lucimobility/luci-sdk-encoders/README.md

# luci-sdk-encoders #
Please note all documentation lives in the [docs folder](docs/1_encoders.md) or at the 
[LUCI SDK](https://lucimobility.github.io/luci-ros2-sdk-docs/) website.
