lucimobility/luci-sdk-encoders/docs/3_firmware.md

# Firmware # 
[GitHub repo](https://github.com/lucimobility/luci-sdk-encoders)
The encoder board is based on the [Arduino Uno](https://store.arduino.cc/products/arduino-uno-rev3)
