lucimobility/luci-sdk-encoders/docs/2_shield.md

# Shield #
Shield
The shield was designed with KiCad. All future changes to the board will be kept in KiCad.

## Design ##
Schematic pdf can be found [here](files/schematic.pdf)

## BOM ##
Bill of Materials can be found [here](files/shield-purchase.csv)
