lucimobility/luci-sdk-encoders/Hardware/ENCODER PCB MOUNT.STEP

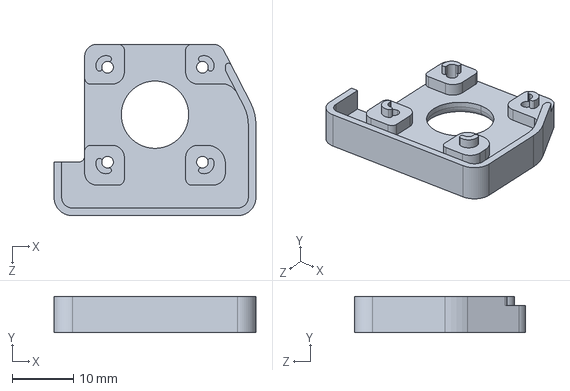
[picture p3: CAD file, 2023-06-07]
Hardware/ENCODER PCB MOUNT.STEP
33.0 x 5.90 x 28.0 mm
