lucimobility/luci-sdk-encoders/Hardware/Permobil_F3/ENCODER MOUNT ARM- PERMOBIL F3.STEP

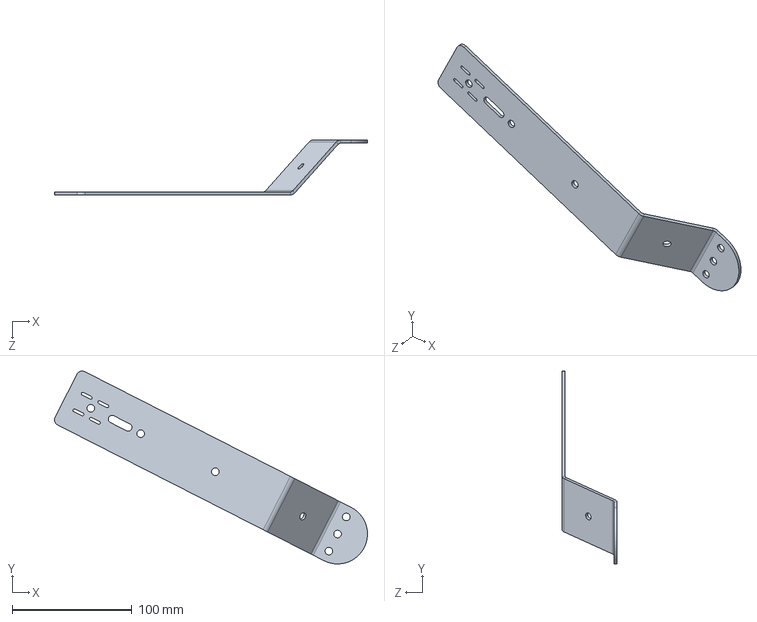
[picture p4: CAD file, 2023-06-07]
Hardware/Permobil_F3/ENCODER MOUNT ARM- PERMOBIL F3.STEP
261.4 x 161.1 x 46.0 mm
