lucimobility/luci-sdk-encoders/Hardware/Permobil_M3/INNER ENCODER MOUNT- PERMOBIL M3.STEP

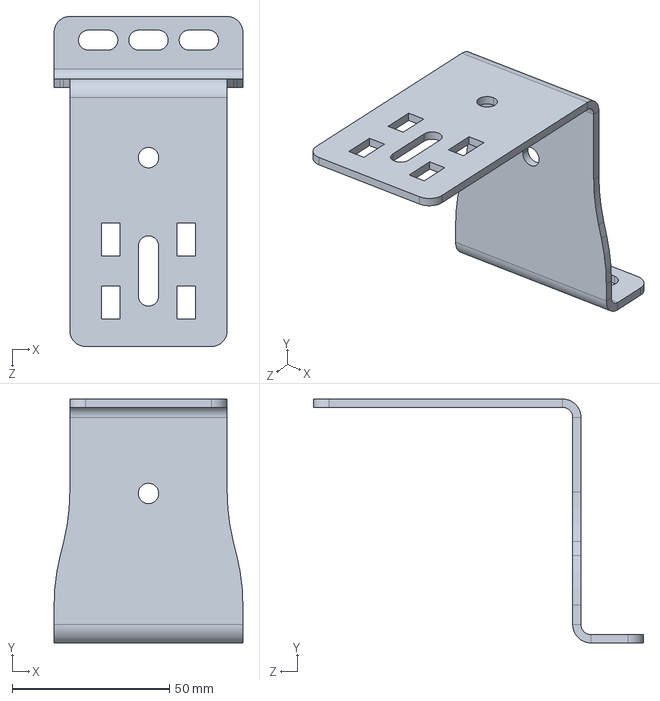
[picture p5: CAD file, 2023-06-07]
Hardware/Permobil_M3/INNER ENCODER MOUNT- PERMOBIL M3.STEP
60.0 x 77.5 x 104.8 mm
