lucimobility/luci-sdk-encoders/Hardware/Quickie_300M/ENCODER WHEEL ADAPTER- Q300M.STEP

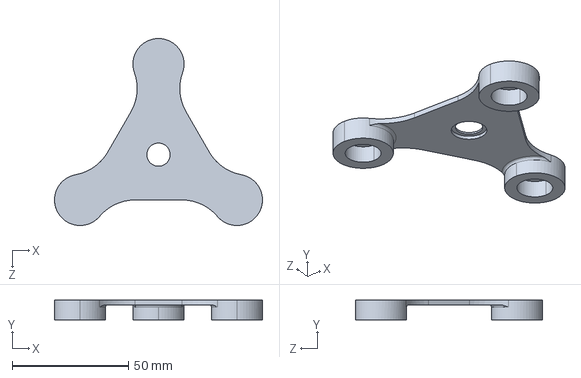
[picture p6: CAD file, 2023-06-07]
Hardware/Quickie_300M/ENCODER WHEEL ADAPTER- Q300M.STEP
89.5 x 8.50 x 80.5 mm
