lucimobility/luci-sdk-encoders/Hardware/Permobil_F3/ENCODER MOUNT- PERMOBIL F3.STEP

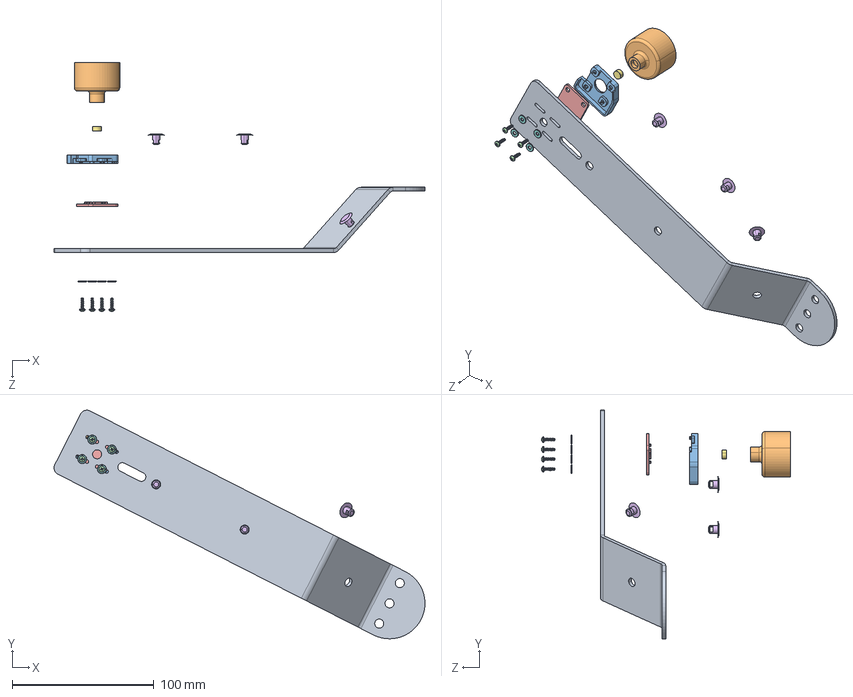
[picture p7: CAD file, 2023-06-07]
Hardware/Permobil_F3/ENCODER MOUNT- PERMOBIL F3.STEP
261.4 x 161.1 x 175.3 mm
ENCODER MOUNT ARM- PERMOBIL F3_default
ENCODER WHEEL ADAPTER- PERMOBIL F3_417-00011
ENCODER PCB MOUNT_417-00010
SCREW- #2 X 0.375_default x 4
ENCODER PCB_ENCODER PCB
CABLE TIE MOUNT_default x 3
MAGNET- NEODYMIUM 0.25 X 0.125_default
WASHER- #2_default x 4
