lucimobility/luci-sdk-encoders/Hardware/Permobil_M3/OUTER ENCODER MOUNT- PERMOBIL M3.STEP

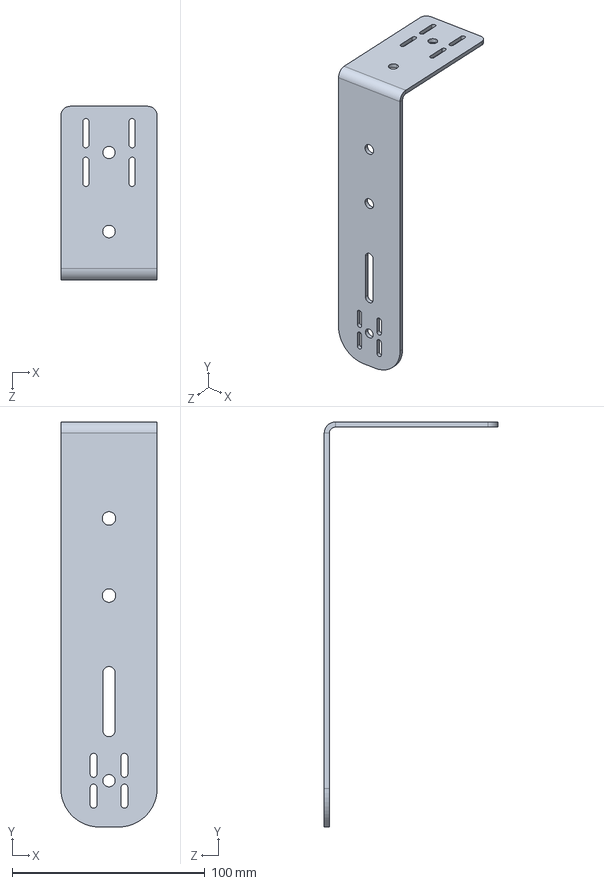
[picture p8: CAD file, 2023-06-07]
Hardware/Permobil_M3/OUTER ENCODER MOUNT- PERMOBIL M3.STEP
50.0 x 210.0 x 90.0 mm
