lucimobility/luci-sdk-encoders/Hardware/Quickie_500M/LEFT INNER ENCODER MOUNT- Q300M.STEP

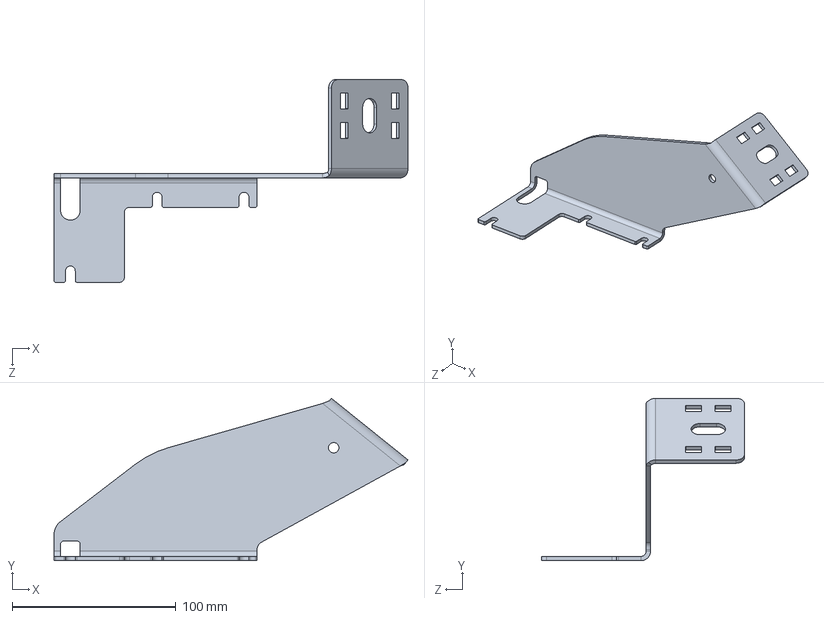
[picture p9: CAD file, 2023-06-07]
Hardware/Quickie_500M/LEFT INNER ENCODER MOUNT- Q300M.STEP
216.1 x 99.1 x 123.8 mm
