lucimobility/luci-sdk-encoders/Hardware/Permobil_F3/ENCODER WHEEL ADAPTER- PERMOBIL F3.STEP

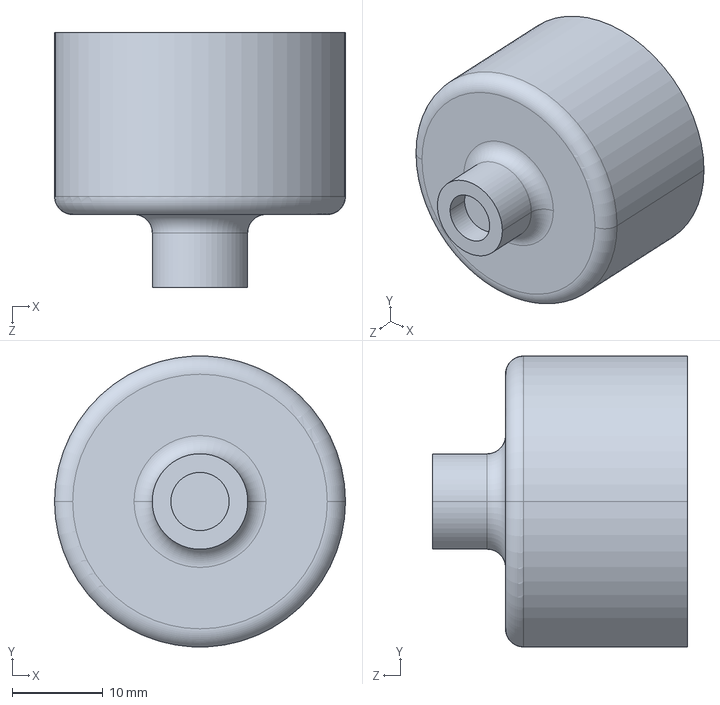
[picture p10: CAD file, 2023-06-07]
Hardware/Permobil_F3/ENCODER WHEEL ADAPTER- PERMOBIL F3.STEP
32.0 x 32.0 x 28.0 mm
