lucimobility/luci-sdk-encoders/Hardware/Quickie_300M/OUTER ENCODER MOUNT- Q300M.STEP

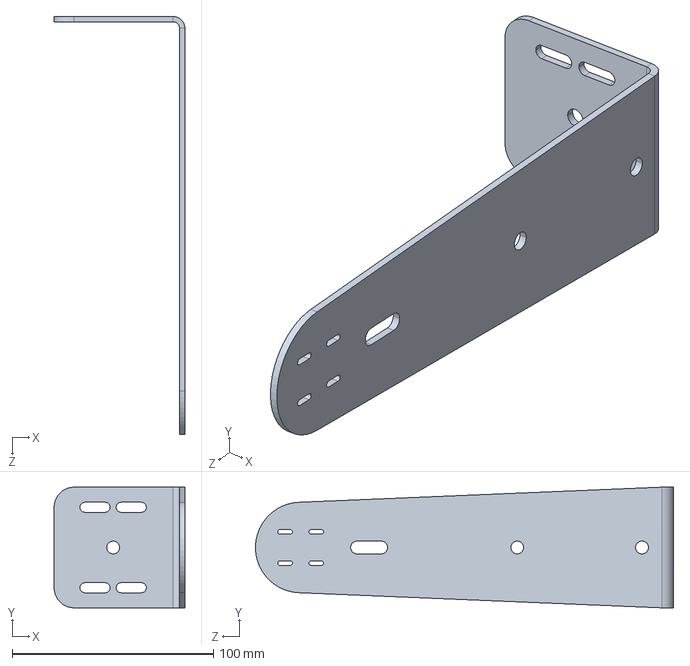
[picture p11: CAD file, 2023-06-07]
Hardware/Quickie_300M/OUTER ENCODER MOUNT- Q300M.STEP
65.0 x 60.0 x 207.8 mm
