lucimobility/luci-sdk-encoders/(list of files, cad)

Other CAD files:
Hardware/Quickie_500M/RIGHT INNER ENCODER MOUNT- Q300M.STEP
Hardware/Quickie_300M/RIGHT INNER ENCODER MOUNT- Q300M.STEP
Hardware/ENCODER PCB MOUNT.STL
Hardware/Quickie_500M/ENCODER MAGNET MOUNT- Q300M.STL
Hardware/Quickie_500M/ENCODER WHEEL ADAPTER- Q300M.STL
