lucimobility/luci-sdk-encoders/Hardware/ENCODER PCB MOUNT.PDF

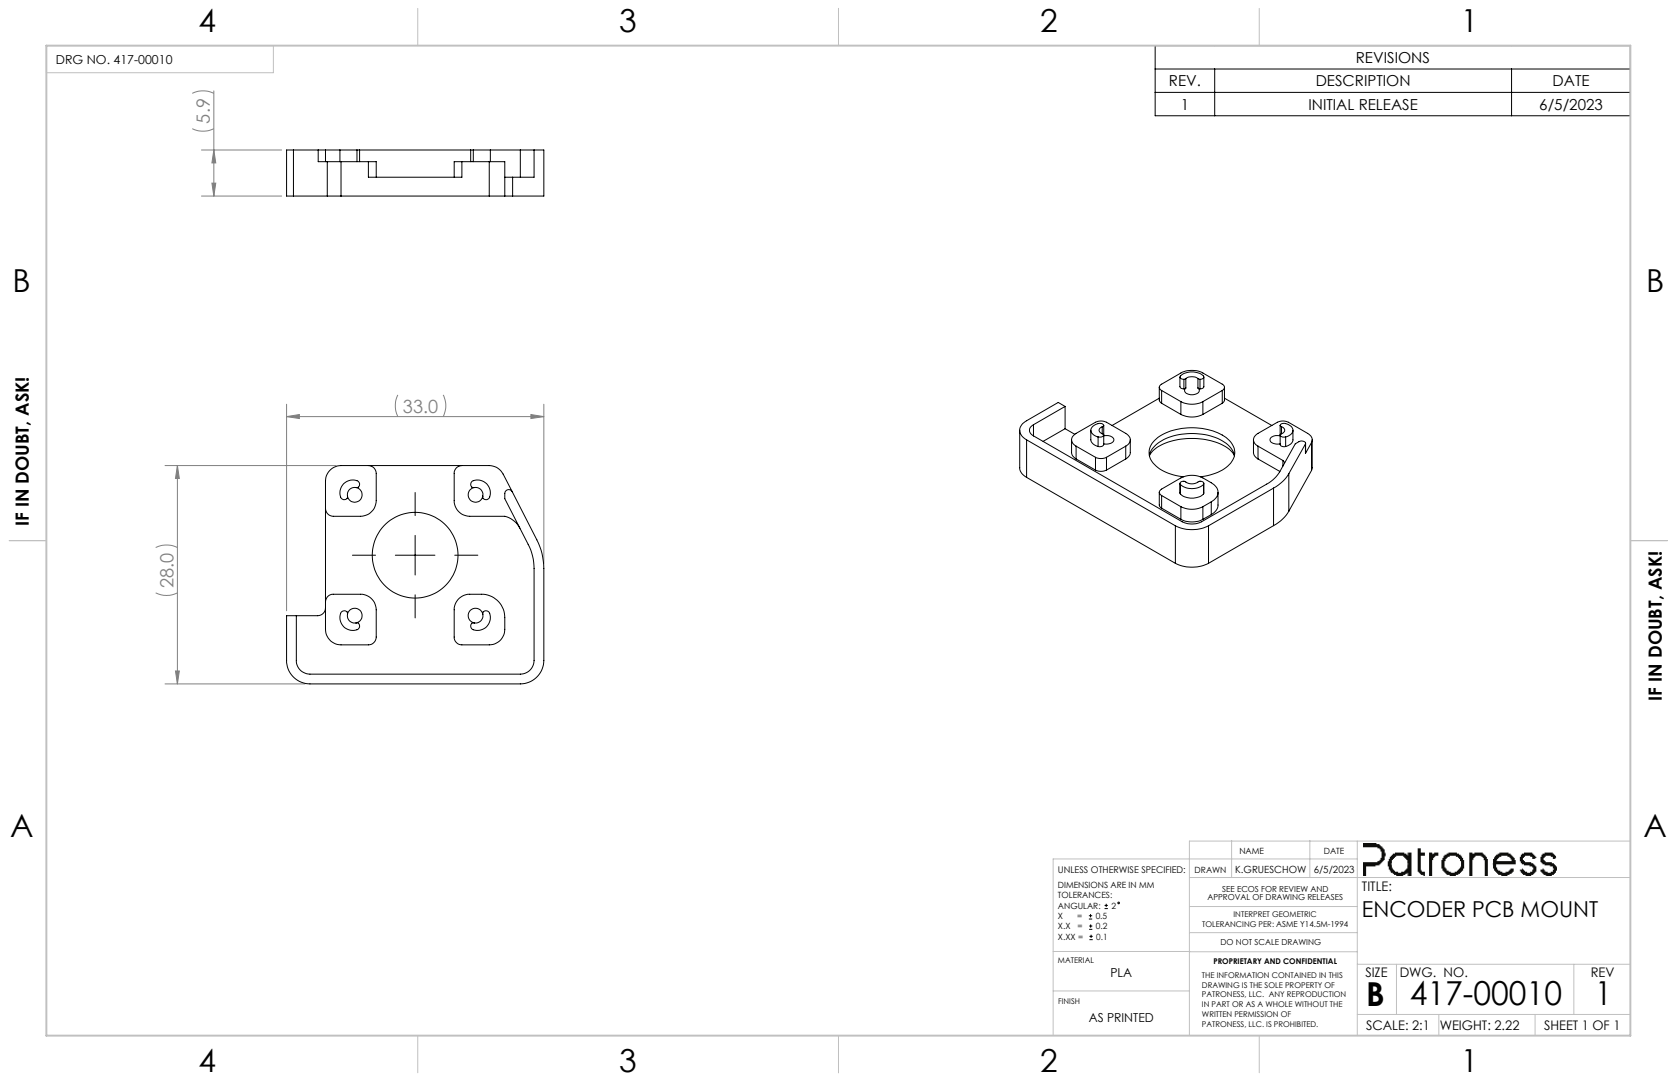
[picture p12: page 1]
AS PRINTED

DRG NO. 417-00010 | | REVISIONS

REV. | INITIAL RELEASE DESCRIPTION | 6/5/2023 DATE 1

IF IN DOUBT, ASK!

NAME | DATE
SEE ECOS FOR REVIEW AND APPROVAL OF DRAWING RELEASES | TITLE: ENCODER PCB MOUNT

UNLESS OTHERWISE SPECIFIED: DIMENSIONS ARE IN MM TOLERANCES: ANGULAR: 2 X = 0.5 X.X = 0.2 X.XX = 0.1 | DRAWN | K.GRUESCHOW | 6/5/2023

INTERPRET GEOMETRIC
TOLERANCING PER: ASME Y14.5M-1994
DO NOT SCALE DRAWING
PROPRIETARY AND CONFIDENTIAL
THE INFORMATION CONTAINED IN THIS
DRAWING IS THE SOLE PROPERTY OF
PATRONESS, LLC. ANY REPRODUCTION
IN PART OR AS A WHOLE WITHOUT THE
WRITTEN PERMISSION OF
PATRONESS, LLC. IS PROHIBITED.

SIZE B | DWG. NO. 417-00010 | REV 1

SCALE: 2:1 | WEIGHT: 2.22 | SHEET 1 OF 1
