lucimobility/luci-sdk-encoders/Hardware/Permobil_F3/ENCODER MOUNT ARM- PERMOBIL F3.PDF

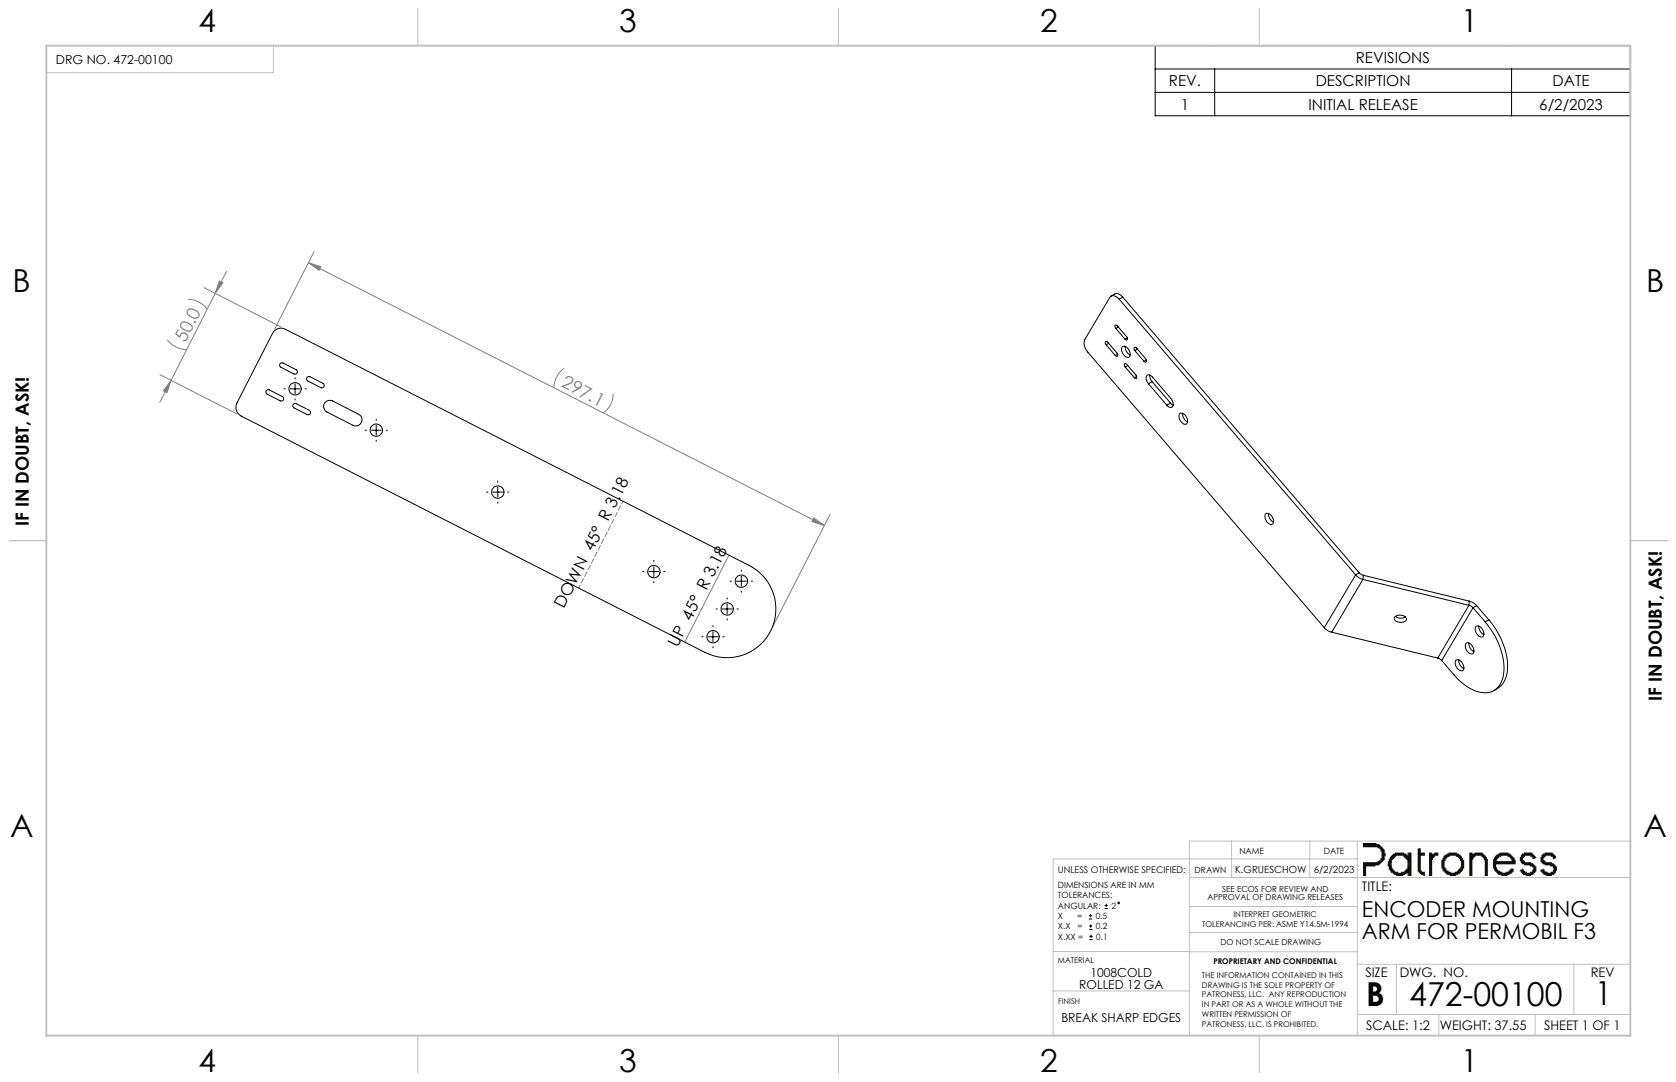
[picture p13: page 1]
DOWN 45° R 3.18; BREAK SHARP EDGES; ROLLED 12 GA

DRG NO. 472-00100 | | REVISIONS

REV. | INITIAL RELEASE DESCRIPTION | 6/2/2023 DATE 1

IF IN DOUBT, ASK!

NAME | DATE
SEE ECOS FOR REVIEW AND APPROVAL OF DRAWING RELEASES | TITLE: ENCODER MOUNTING ARM FOR PERMOBIL F3

UNLESS OTHERWISE SPECIFIED: DIMENSIONS ARE IN MM TOLERANCES: ANGULAR: 2 X = 0.5 X.X = 0.2 X.XX = 0.1 | DRAWN | K.GRUESCHOW | 6/2/2023

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

SIZE B | DWG. NO. 472-00100 | REV 1

SCALE: 1:2 | WEIGHT: 37.55 | SHEET 1 OF 1
