lucimobility/luci-sdk-encoders/Hardware/Permobil_F3/ENCODER MOUNT ASSEMBLY- PERMOBIL F3.PDF

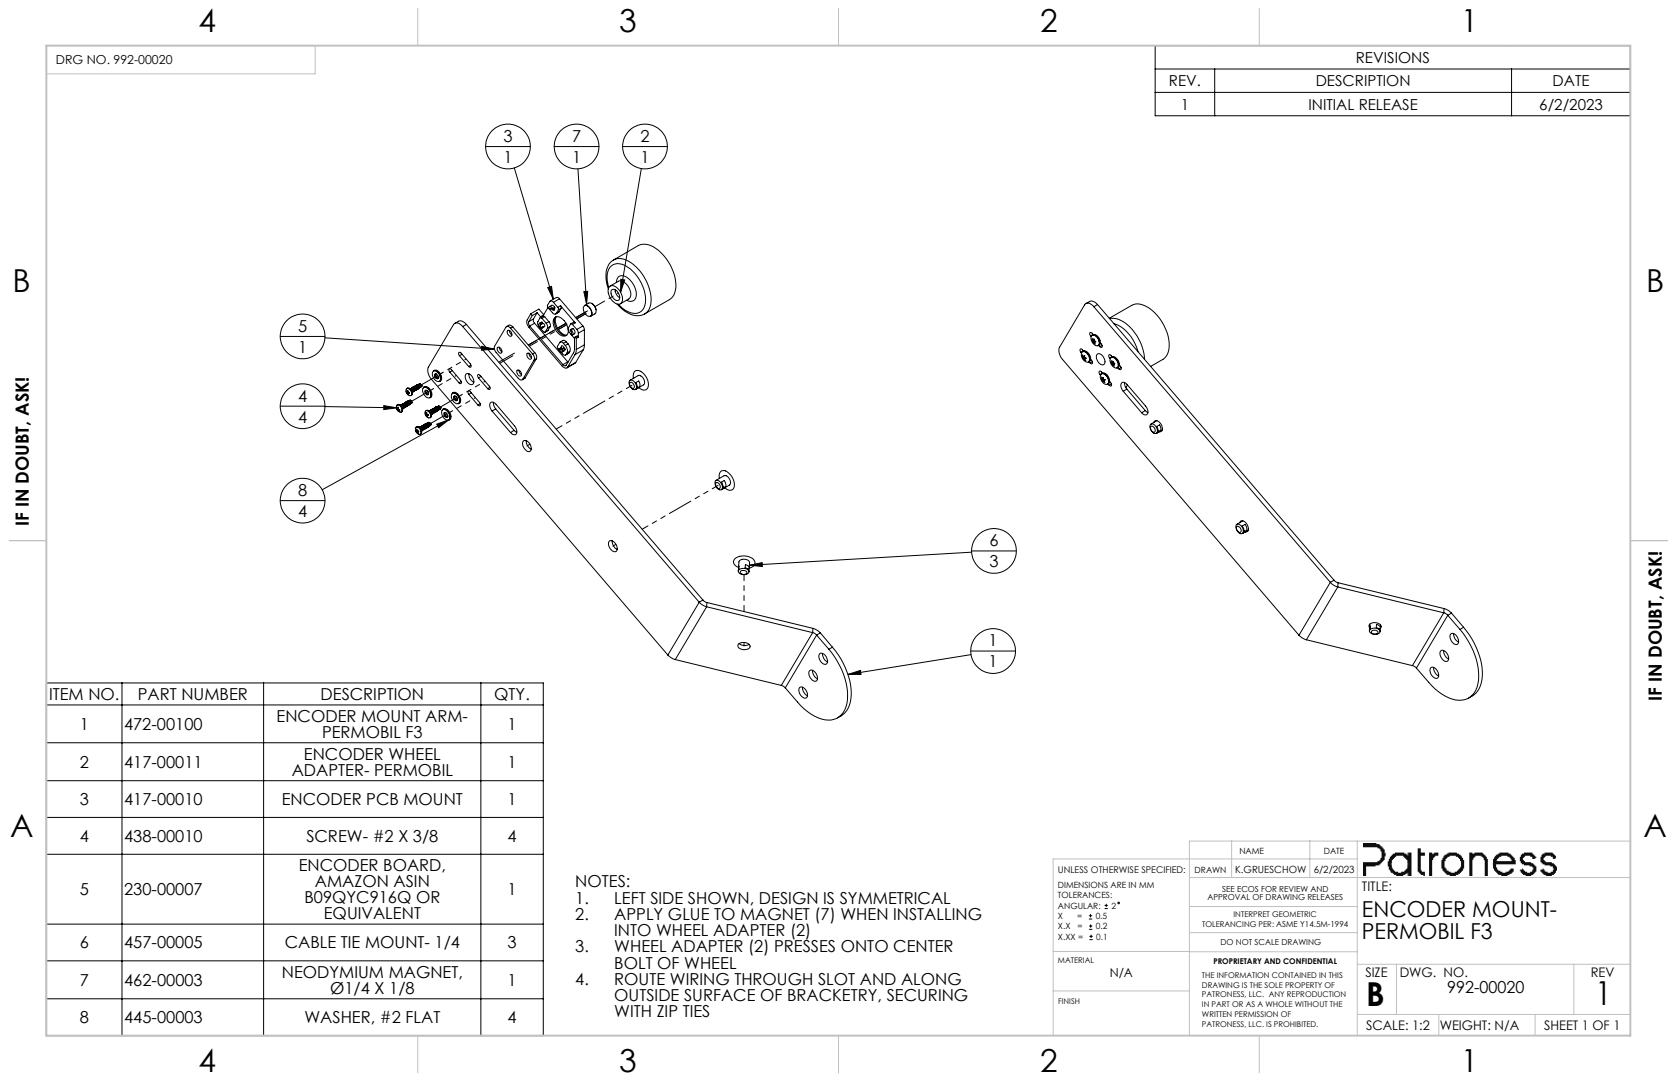
[picture p14: page 1]
NEODYMIUM MAGNET,; DWG. NO.; REV

DRG NO. 992-00020 | | REVISIONS

REV. | DESCRIPTION | DATE
1 | INITIAL RELEASE | 6/2/2023

IF IN DOUBT, ASK!

ITEM NO. | PART NUMBER | DESCRIPTION | QTY.
1 | 472-00100 | ENCODER MOUNT ARM-PERMOBIL F3 | 1
2 | 417-00011 | ENCODER WHEEL ADAPTER- PERMOBIL | 1

3 | 417-00010 | ENCODER PCB MOUNT | 1
4 | 438-00010 | SCREW- #2 X 3/8 | 4
5 | 230-00007 | ENCODER BOARD, AMAZON ASIN B09QYC916Q OR EQUIVALENT | 1

NAME | DATE
SEE ECOS FOR REVIEW AND APPROVAL OF DRAWING RELEASES | TITLE: ENCODER MOUNT-PERMOBIL F3

NOTES:
1. LEFT SIDE SHOWN, DESIGN IS SYMMETRICAL
2. APPLY GLUE TO MAGNET (7) WHEN INSTALLING
INTO WHEEL ADAPTER (2)
3. WHEEL ADAPTER (2) PRESSES ONTO CENTER
BOLT OF WHEEL
4. ROUTE WIRING THROUGH SLOT AND ALONG
OUTSIDE SURFACE OF BRACKETRY, SECURING
WITH ZIP TIES

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

6 | 457-00005 | CABLE TIE MOUNT- 1/4 | 3

8 | 445-00003 | WASHER, #2 FLAT | 4

SCALE: 1:2 | WEIGHT: N/A | SHEET 1 OF 1
