lucimobility/luci-sdk-encoders/Hardware/Permobil_M3/ENCODER MOUNT ASSEMBLY- PERMOBIL M3.PDF

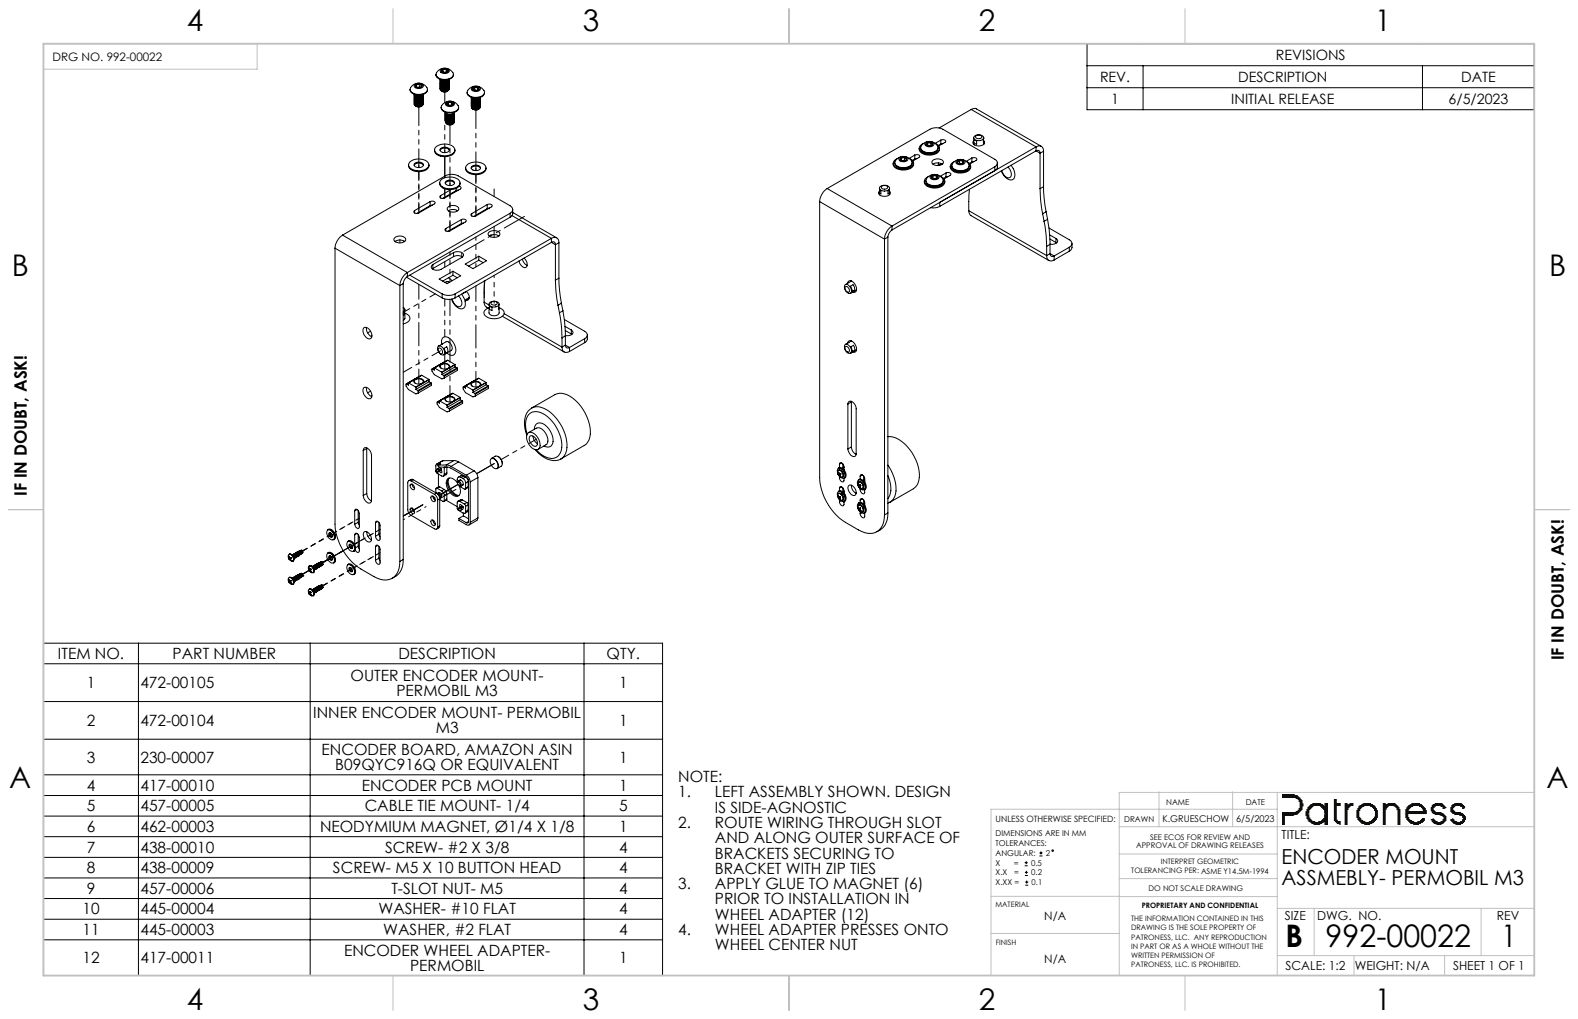
[picture p15: page 1]
CABLE TIE MOUNT- 1/4; T-SLOT NUT- M5; WASHER- #10 FLAT

DRG NO. 992-00022 | | REVISIONS

REV. | DESCRIPTION | DATE
1 | INITIAL RELEASE | 6/5/2023

IF IN DOUBT, ASK!

ITEM NO. | PART NUMBER | DESCRIPTION | QTY.
1 | 472-00105 | OUTER ENCODER MOUNT-PERMOBIL M3 | 1
2 | 472-00104 | INNER ENCODER MOUNT- PERMOBIL M3 | 1
3 | 230-00007 | ENCODER BOARD, AMAZON ASIN B09QYC916Q OR EQUIVALENT | 1
4 | 417-00010 | ENCODER PCB MOUNT | 1

NOTE:
1. LEFT ASSEMBLY SHOWN. DESIGN
IS SIDE-AGNOSTIC
2. ROUTE WIRING THROUGH SLOT
AND ALONG OUTER SURFACE OF
BRACKETS SECURING TO
BRACKET WITH ZIP TIES
3. APPLY GLUE TO MAGNET (6)
PRIOR TO INSTALLATION IN
WHEEL ADAPTER (12)
4. WHEEL ADAPTER PRESSES ONTO
WHEEL CENTER NUT

6 | 462-00003 | NEODYMIUM MAGNET, Ø1/4 X 1/8 | 1
7 | 438-00010 | SCREW- #2 X 3/8 | 4
8 | 438-00009 | SCREW- M5 X 10 BUTTON HEAD | 4

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

SEE ECOS FOR REVIEW AND APPROVAL OF DRAWING RELEASES | TITLE: ENCODER MOUNT ASSMEBLY- PERMOBIL M3

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

SIZE B | DWG. NO. 992-00022 | REV 1

11 | 445-00003 | WASHER, #2 FLAT | 4
12 | 417-00011 | ENCODER WHEEL ADAPTER-PERMOBIL | 1

SCALE: 1:2 | WEIGHT: N/A | SHEET 1 OF 1
