lucimobility/luci-sdk-encoders/Hardware/Permobil_M3/INNER ENCODER MOUNT- PERMOBIL M3.PDF

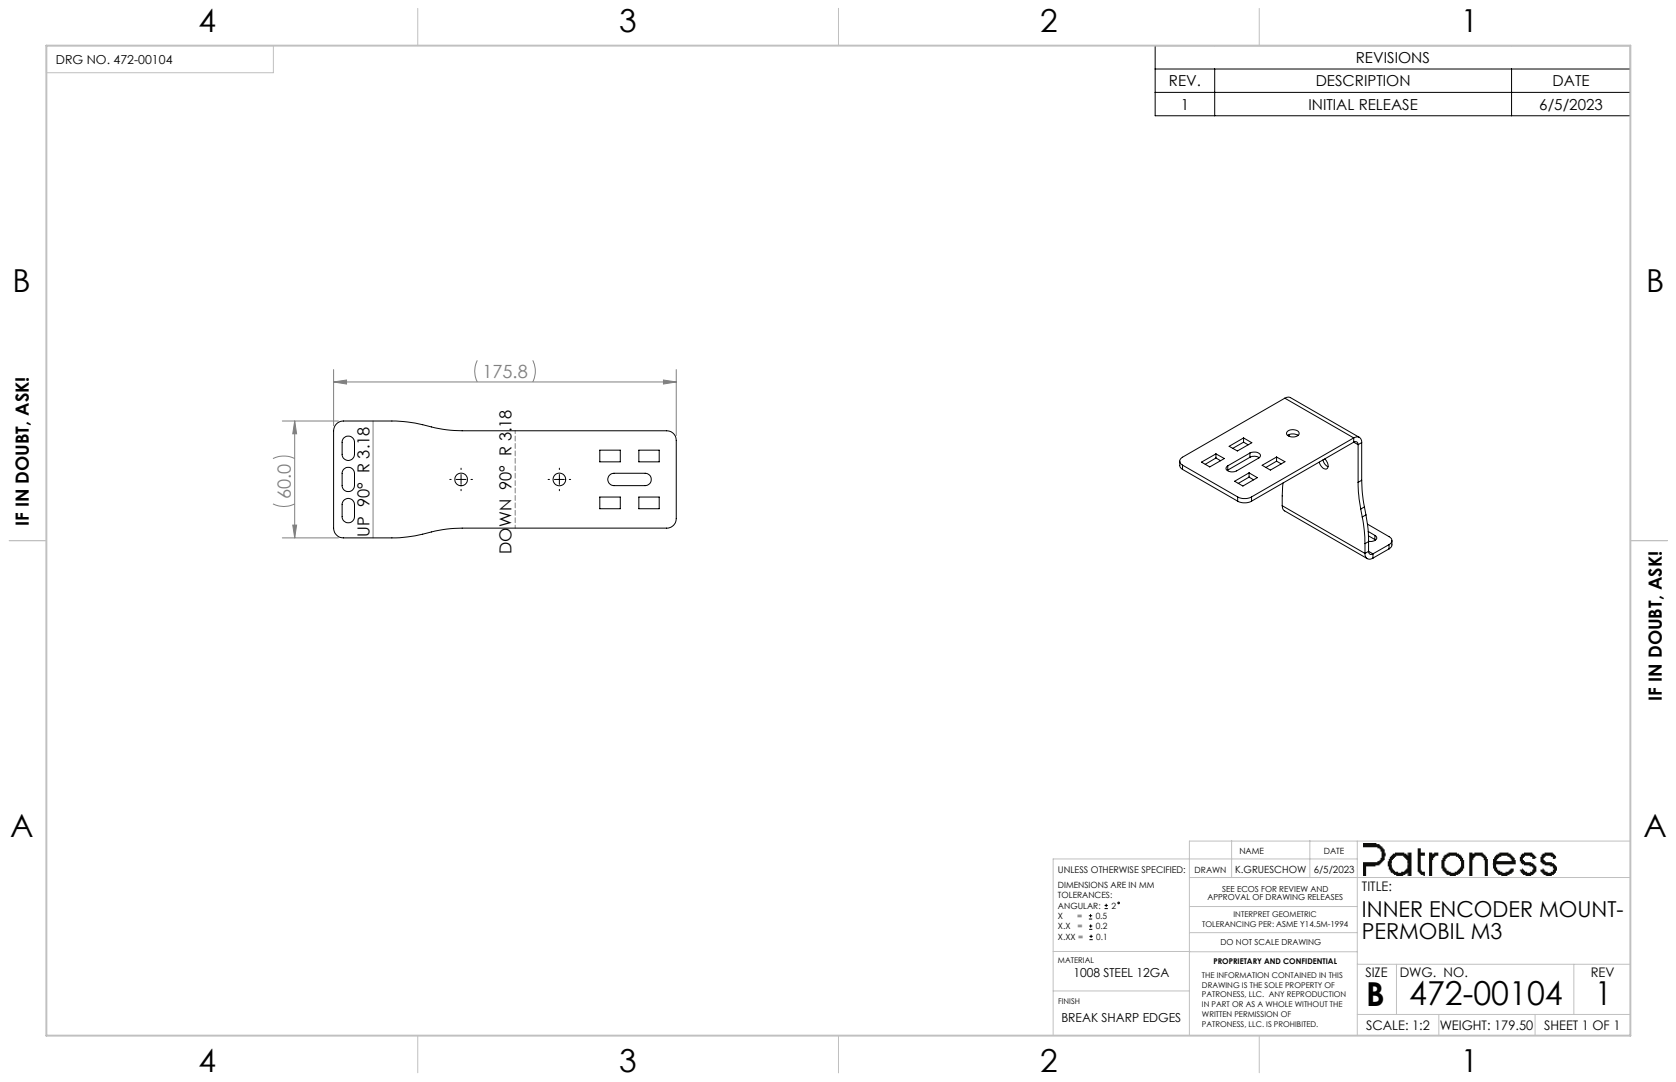
[picture p16: page 1]
DOWN 90° R 3.18; 1008 STEEL 12GA

DRG NO. 472-00104 | | REVISIONS

REV. | INITIAL RELEASE DESCRIPTION | 6/5/2023 DATE 1

IF IN DOUBT, ASK!

NAME | DATE
SEE ECOS FOR REVIEW AND APPROVAL OF DRAWING RELEASES | TITLE: INNER ENCODER MOUNT-PERMOBIL M3

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

SIZE B | DWG. NO. 472-00104 | REV 1

FINISH
BREAK SHARP EDGES

SCALE: 1:2 | WEIGHT: 179.50 | SHEET 1 OF 1
