lucimobility/luci-sdk-encoders/Hardware/Quickie_300M/ENCODER MAGNET MOUNT- Q300M.PDF

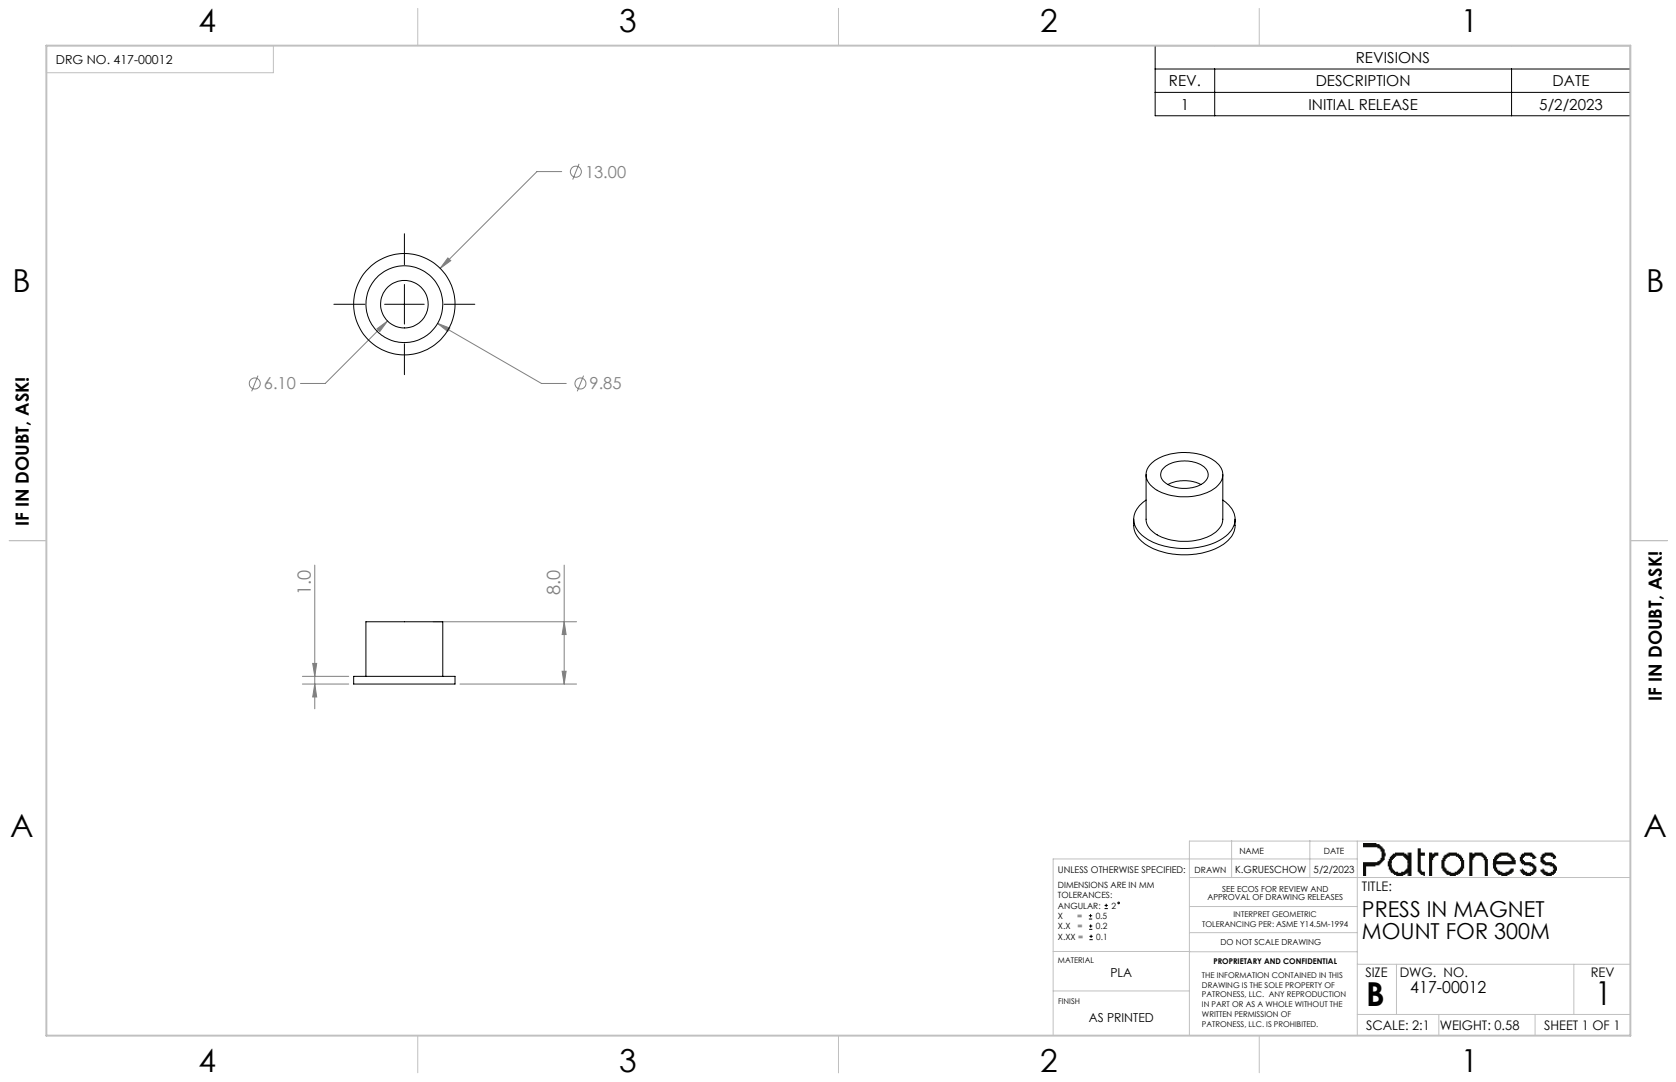
[picture p17: page 1]
AS PRINTED

DRG NO. 417-00012 | | REVISIONS

REV. | INITIAL RELEASE DESCRIPTION | 5/2/2023 DATE 1

IF IN DOUBT, ASK!

NAME | DATE
SEE ECOS FOR REVIEW AND APPROVAL OF DRAWING RELEASES | TITLE: PRESS IN MAGNET MOUNT FOR 300M

UNLESS OTHERWISE SPECIFIED: DIMENSIONS ARE IN MM TOLERANCES: ANGULAR: 2 X = 0.5 X.X = 0.2 X.XX = 0.1 | DRAWN | K.GRUESCHOW | 5/2/2023

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

SIZE B | DWG. NO. | REV 1 417-00012

SCALE: 2:1 | WEIGHT: 0.58 | SHEET 1 OF 1
