lucimobility/luci-sdk-encoders/Hardware/Quickie_300M/ENCODER WHEEL ADAPTER- Q300M.PDF

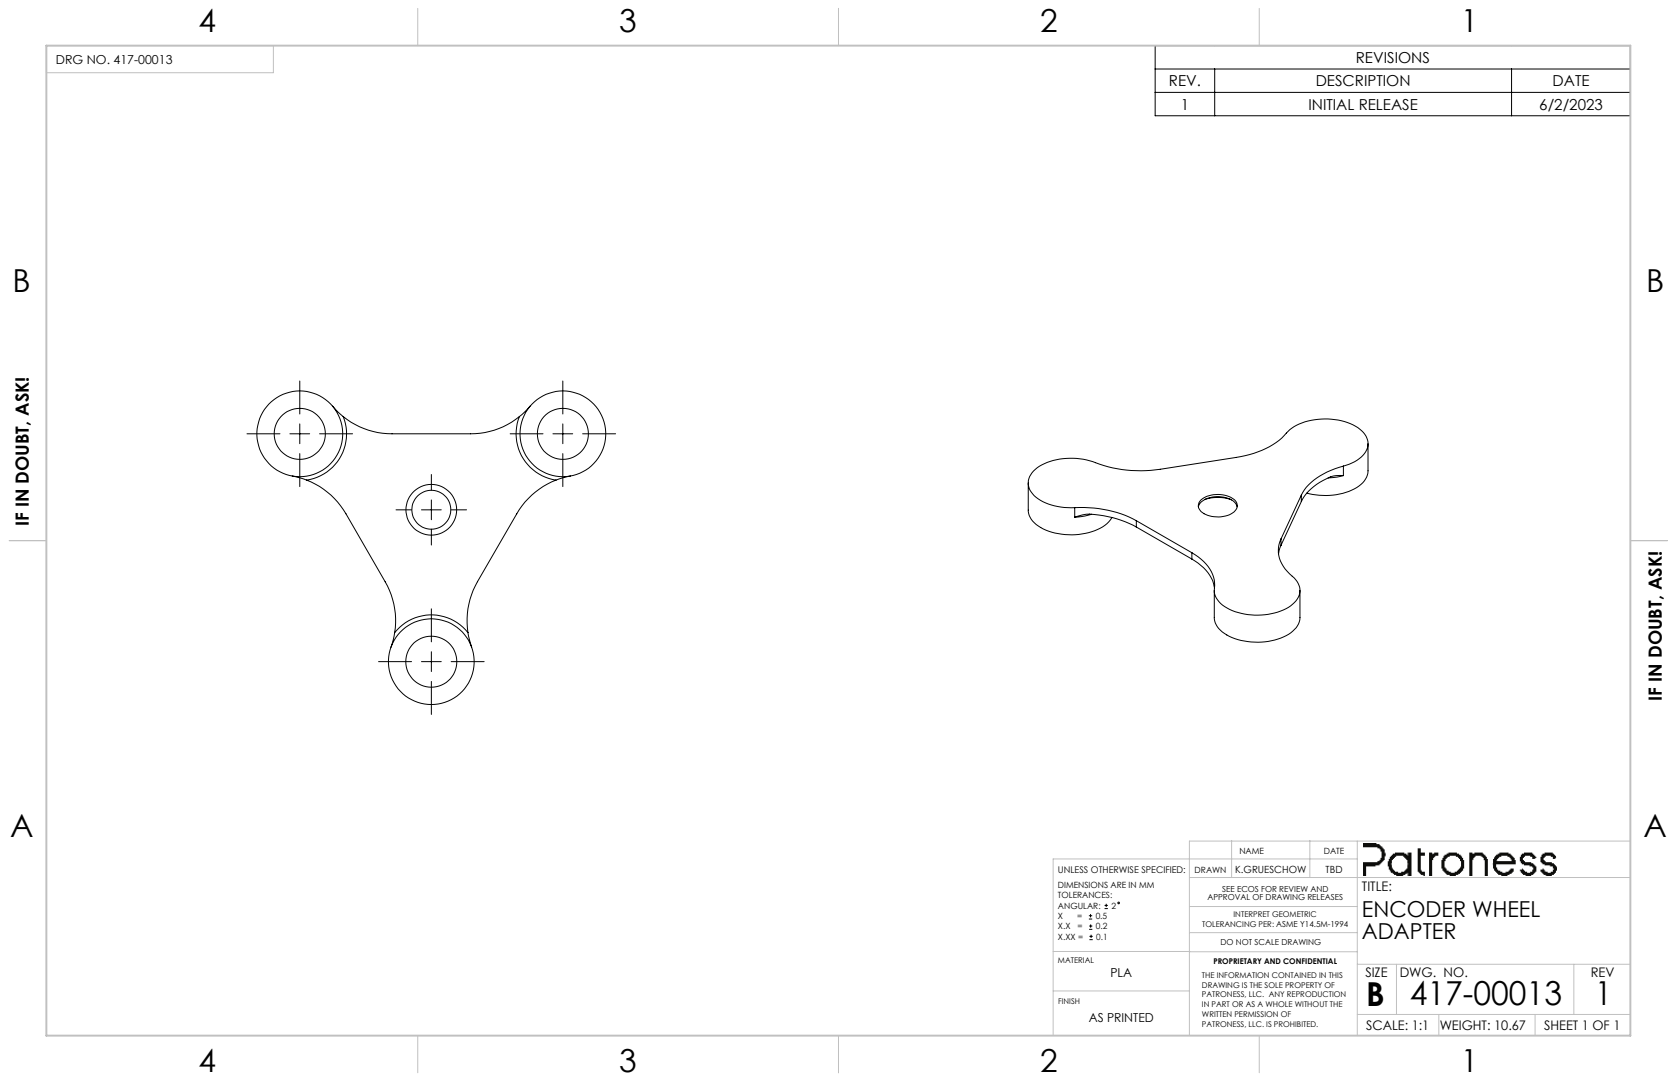
[picture p19: page 1]
AS PRINTED

DRG NO. 417-00013 | | REVISIONS

REV. | INITIAL RELEASE DESCRIPTION | 6/2/2023 DATE 1

IF IN DOUBT, ASK!

NAME | DATE
SEE ECOS FOR REVIEW AND APPROVAL OF DRAWING RELEASES | TITLE: ENCODER WHEEL ADAPTER

UNLESS OTHERWISE SPECIFIED: DIMENSIONS ARE IN MM TOLERANCES: ANGULAR: 2 X = 0.5 X.X = 0.2 X.XX = 0.1 | DRAWN | K.GRUESCHOW | TBD

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

SIZE B | DWG. NO. 417-00013 | REV 1

SCALE: 1:1 | WEIGHT: 10.67 | SHEET 1 OF 1
