lucimobility/luci-sdk-encoders/docs/files/schematic.pdf

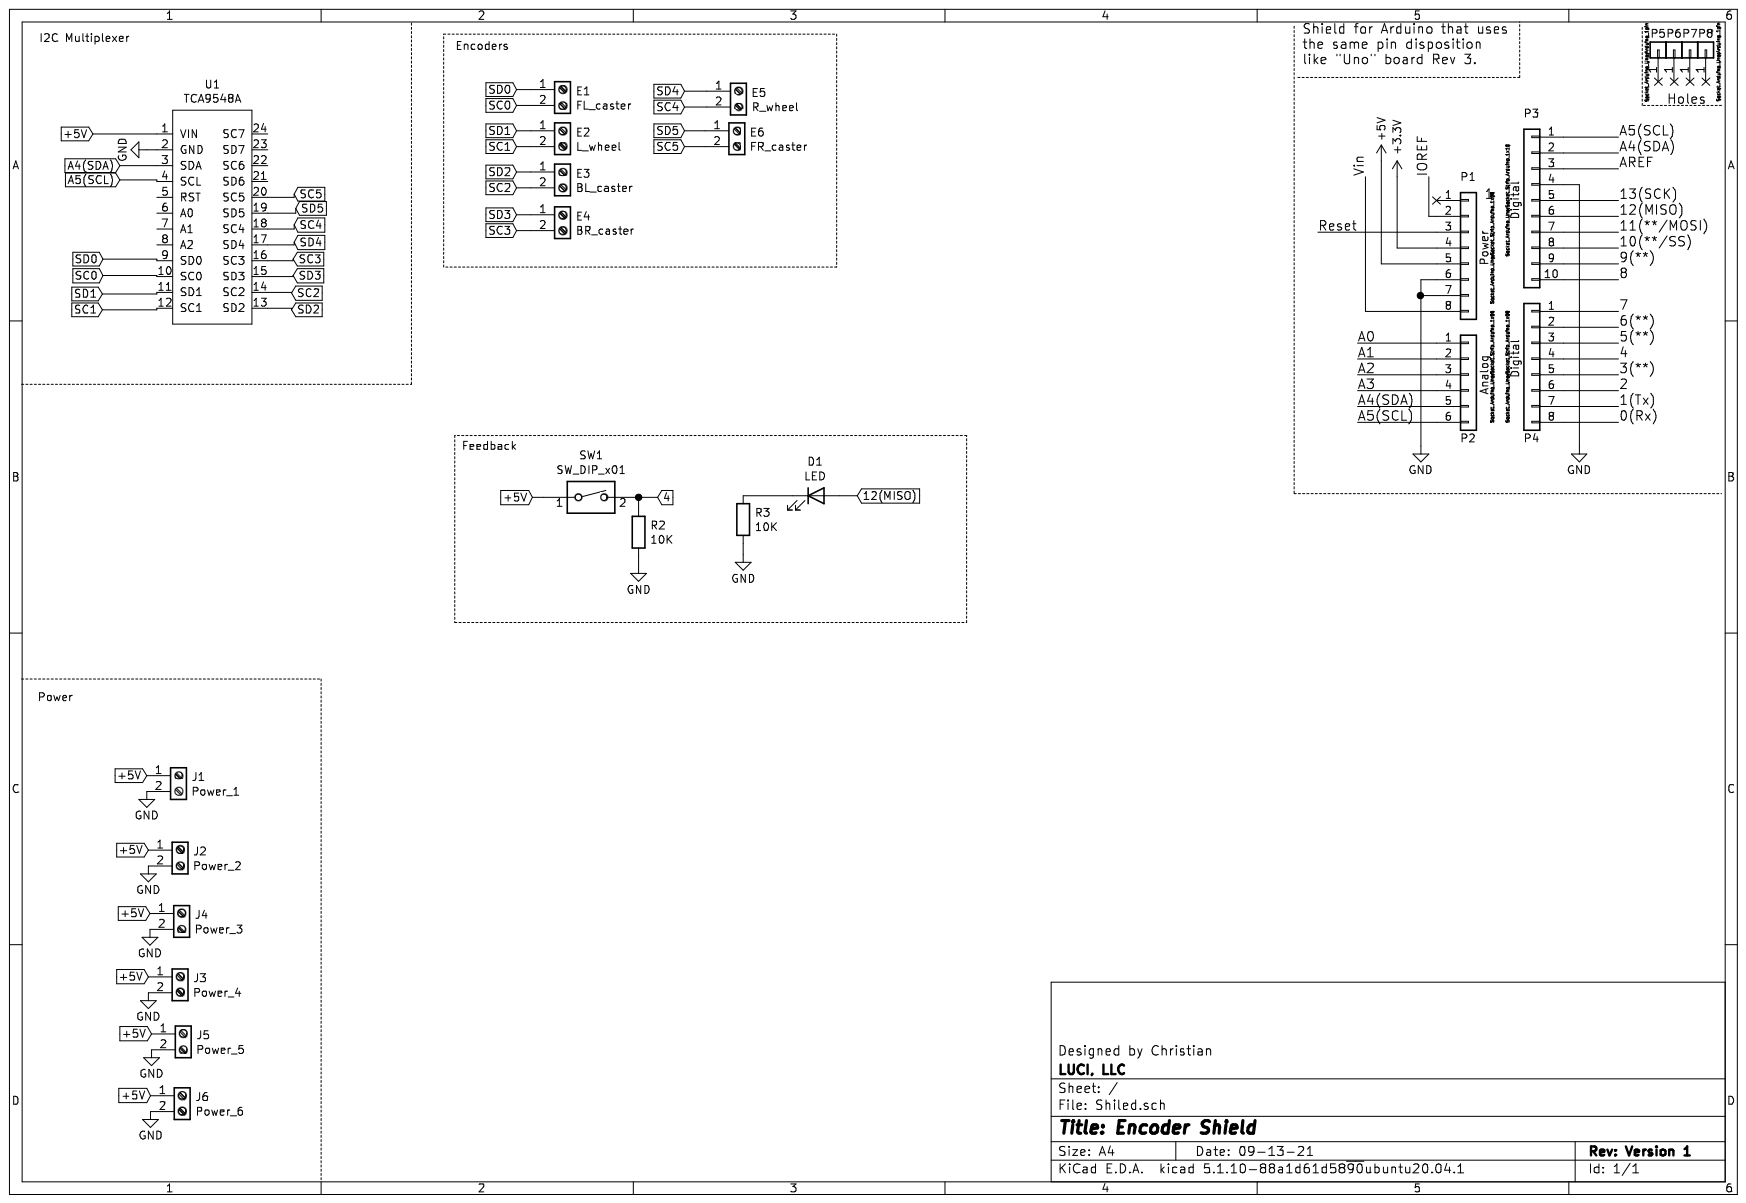
[picture p20: page 1]
