lucimobility/luci-sdk-encoders/Shield/Shiled.kicad_pcb

## KiCad design Shield/Shiled.kicad_pcb (2023-05-31)

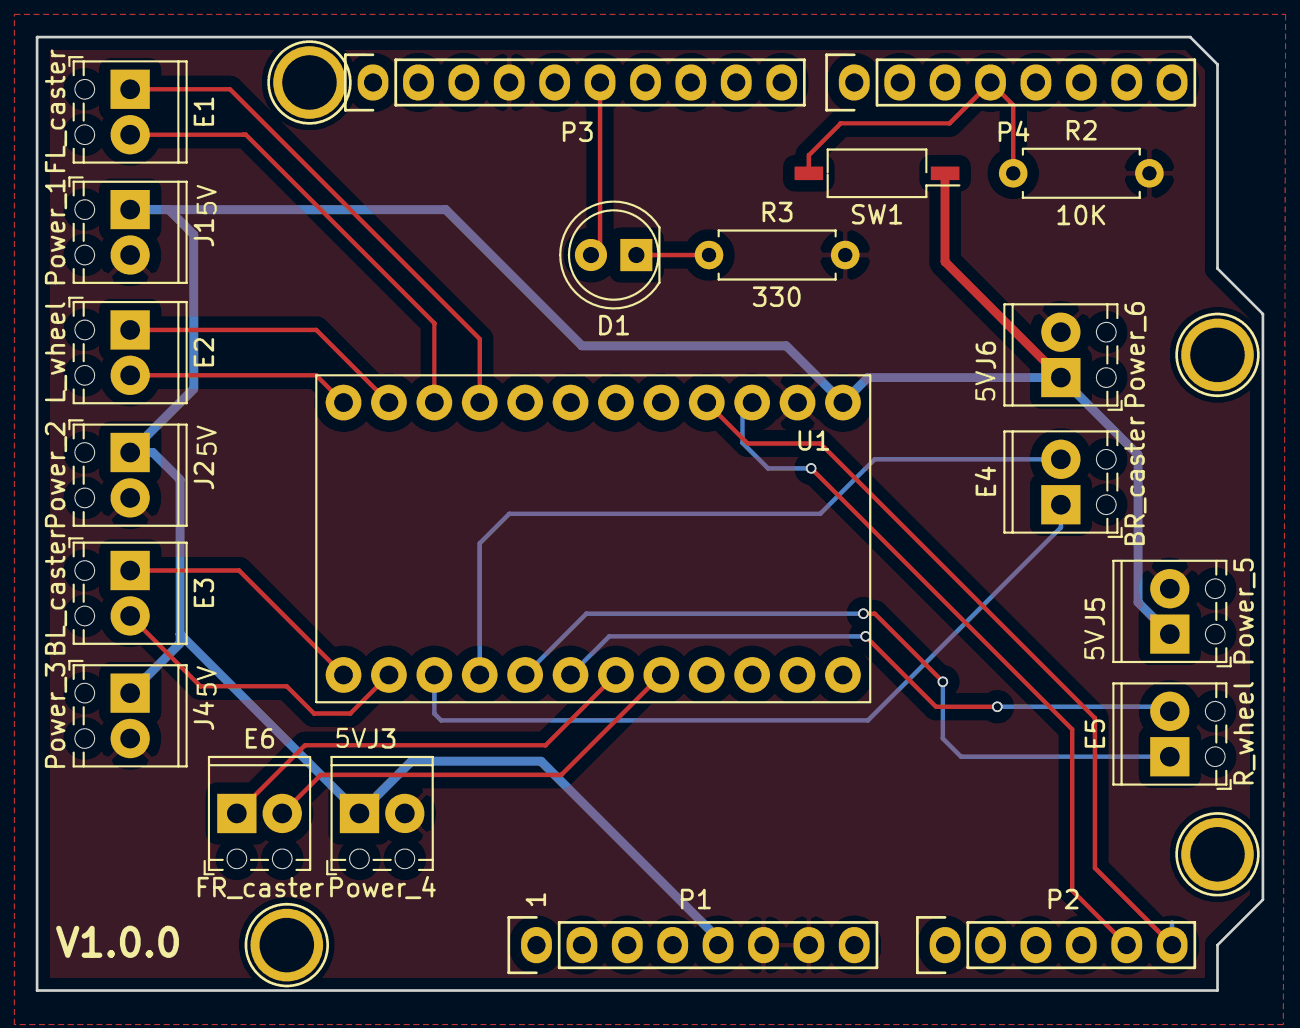
[picture p21: board Shiled.kicad_pcb from above]

Board: 2 copper layers, 68.6 x 53.3 mm, 25 parts (0 on the bottom side), 19 nets.

Parts:
D1: LED; LED_D5.0mm
E1: FL_caster; TerminalBlock_Phoenix_MPT-0,5-2-2.54_1x02_P2.54mm_Horizontal
E2: L_wheel; TerminalBlock_Phoenix_MPT-0,5-2-2.54_1x02_P2.54mm_Horizontal
E3: BL_caster; TerminalBlock_Phoenix_MPT-0,5-2-2.54_1x02_P2.54mm_Horizontal
E4: BR_caster; TerminalBlock_Phoenix_MPT-0,5-2-2.54_1x02_P2.54mm_Horizontal
E5: R_wheel; TerminalBlock_Phoenix_MPT-0,5-2-2.54_1x02_P2.54mm_Horizontal
E6: FR_caster; TerminalBlock_Phoenix_MPT-0,5-2-2.54_1x02_P2.54mm_Horizontal
J1: Power_1; TerminalBlock_Phoenix_MPT-0,5-2-2.54_1x02_P2.54mm_Horizontal
J2: Power_2; TerminalBlock_Phoenix_MPT-0,5-2-2.54_1x02_P2.54mm_Horizontal
J3: Power_4; TerminalBlock_Phoenix_MPT-0,5-2-2.54_1x02_P2.54mm_Horizontal
J4: Power_3; TerminalBlock_Phoenix_MPT-0,5-2-2.54_1x02_P2.54mm_Horizontal
J5: Power_5; TerminalBlock_Phoenix_MPT-0,5-2-2.54_1x02_P2.54mm_Horizontal
J6: Power_6; TerminalBlock_Phoenix_MPT-0,5-2-2.54_1x02_P2.54mm_Horizontal
P1: Power; Socket_Strip_Arduino_1x08
P2: Analog; Socket_Strip_Arduino_1x06
P3: Digital; Socket_Strip_Arduino_1x10
P4: Digital; Socket_Strip_Arduino_1x08
P5, P6, P7, P8: CONN_01X01; Arduino_1pin
R2: 10K; R_Axial_DIN0207_L6.3mm_D2.5mm_P7.62mm_Horizontal
R3: 330; R_Axial_DIN0207_L6.3mm_D2.5mm_P7.62mm_Horizontal
SW1: SW_DIP_x01; SW_DIP_SPSTx01_Slide_Copal_CHS-01B_W7.62mm_P1.27mm
U1: TCA9548A

Connections:
4: P4.4, R2.1, SW1.2
12(MISO): D1.2, P3.6
+5V: J1.1, J2.1, J3.1, J4.1, J5.1, J6.1, P1.5, SW1.1, U1.1
A4(SDA): P2.5, P3.2, U1.3
A5(SCL): P2.6, P3.1, U1.4
GND: J1.2, J2.2, J3.2, J4.2, J5.2, J6.2, P1.6, P1.7, P3.4, R2.2, R3.2, U1.2
unnamed: D1.1, R3.1
SC0: E1.2, U1.10
SC1: E2.2, U1.12
SC2: E3.2, U1.14
SC3: E4.2, U1.16
SC4: E5.2, U1.18
SC5: E6.2, U1.20
SD0: E1.1, U1.9
SD1: E2.1, U1.11
SD2: E3.1, U1.13
SD3: E4.1, U1.15
SD4: E5.1, U1.17
SD5: E6.1, U1.19
