lucimobility/luci-sdk-encoders/(commit log)

2023-05-31 Inital Commit
    [Shiled-B_Cu.gbl, Shiled-B_Mask.gbs, Shiled-B_SilkS.gbo, Shiled-Edge_Cuts.gm1, Shiled-F_Cu.gtl, Shiled-F_Mask.gts, Shiled-F_SilkS.gto, Shiled-NPTH.drl]
2023-06-06 Added encoder.md file
2023-06-06 Added shield, firmware, encoder docs
2023-06-07 Added hardware files
    [ENCODER MAGNET MOUNT- Q300M.STEP, ENCODER MOUNT ARM- PERMOBIL F3.STEP, ENCODER MOUNT- PERMOBIL F3.STEP, ENCODER PCB MOUNT.STEP, ENCODER WHEEL ADAPTER- PERMOBIL F3.STEP, ENCODER WHEEL ADAPTER- Q300M.STEP, INNER ENCODER MOUNT- PERMOBIL M3.STEP, LEFT INNER ENCODER MOUNT- Q300M.STEP]
2023-06-16 Added assembly image
2023-07-27 added STL files for Q500M printed parts
    [ENCODER MAGNET MOUNT- Q300M.STL, ENCODER PCB MOUNT.STL, ENCODER WHEEL ADAPTER- Q300M.STL]
2024-02-01 Edited code to work with just drive wheels and changed magnet detection logic
2024-03-06 Added millisecond timestamp
2024-03-06 Update docs for direct mount design
2025-07-16 Add error buffer and error handling. Only send encoder angle data if both left and right have valid data
    [ams5600.ino]
